AqeelJar/Android-Arduino_Face_Detection_Robot/Arduino Uno Robot with Android Face Detection/README.md

## Arduino Uno Robot with Android Face Detection and Tracking

This folder contains the [Android Device](https://github.com/AqeelJar/Android-Arduino_Face_Detection_Robot/blob/main/Arduino%20Uno%20Robot%20with%20Android%20Face%20Detection/FaceDetectResponseApp.slx) Simulink model and [Arduino Uno Controller](https://github.com/AqeelJar/Android-Arduino_Face_Detection_Robot/blob/main/Arduino%20Uno%20Robot%20with%20Android%20Face%20Detection/ContolArduinoRobot.slx) Simulink model.

Follow the [How to run Section](https://github.com/AqeelJar/Android-Arduino_Face_Detection_Robot/tree/main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) for both devices for this application.
