AqeelJar/Android-Arduino_Face_Detection_Robot/Arduino Uno Robot Control/Readme.md

## Control Arduino Uno Robot with Android Device/s
This folder contains the [Arduino Uno Robot Control](https://github.com/AqeelJar/Android-Arduino_Face_Detection_Robot/blob/main/Arduino%20Uno%20Robot%20Control/ContolArduinoRobot.slx) Simulink model for the Arduino Robot.

This folder also contains [direct serial communication](https://github.com/AqeelJar/Android-Arduino_Face_Detection_Robot/tree/main/Arduino%20Uno%20Robot%20Control/Direct%20Serial%20Communication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) and [TCP/IP communication](https://github.com/AqeelJar/Android-Arduino_Face_Detection_Robot/tree/main/Arduino%20Uno%20Robot%20Control/TCP-IP%20Communication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) folders.

Follow the [How to run Section](https://github.com/AqeelJar/Android-Arduino_Face_Detection_Robot#arduino-uno-controller-controlarduinorobotslx) for this application.
