AqeelJar/Android-Arduino_Face_Detection_Robot/Face Detection App/ReadMe.md

## Face Detection Application on Android Device
This folder contains the [Face Detection and reference Simulink model](https://github.com/AqeelJar/Android-Arduino_Face_Detection_Robot/blob/main/Face%20Detection%20App/FaceDetectionApp.slx) for the Android Device

Follow the [How to Run Section](https://github.com/AqeelJar/Android-Arduino_Face_Detection_Robot/tree/main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) for this application.
