AqeelJar/Android-Arduino_Face_Detection_Robot/Arduino Uno Robot Control/TCP-IP Communication/readme.md

## Button Control using a TCP/IP Communication between Android Devices
This folder contains the [server](https://github.com/AqeelJar/Android-Arduino_Face_Detection_Robot/blob/main/Arduino%20Uno%20Robot%20Control/TCP-IP%20Communication/ButtonControlApp_Server.slx) and [client](https://github.com/AqeelJar/Android-Arduino_Face_Detection_Robot/blob/main/Arduino%20Uno%20Robot%20Control/TCP-IP%20Communication/ButtonControlApp_Client.slx) Simulink models for the android devices.

Follow the [How to run Section](https://github.com/AqeelJar/Android-Arduino_Face_Detection_Robot/tree/main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) for this application
