AqeelJar/Android-Arduino_Face_Detection_Robot/Arduino Uno Robot Control/Direct Serial Communication/readme.md

## Button Control using Direct Serial Communication
This folder contains the [direct serial communication](https://github.com/AqeelJar/Android-Arduino_Face_Detection_Robot/blob/main/Arduino%20Uno%20Robot%20Control/Direct%20Serial%20Communication/ButtonControlApp.slx) Simulink model for the Android device.

Follow the [How to Run Section](https://github.com/AqeelJar/Android-Arduino_Face_Detection_Robot/tree/main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) for this application.
