AqeelJar/Android-Arduino_Face_Detection_Robot/Additional Codes/Obstacle_Avoidance.ino

// Obstacle Avoidance Code
#include <Servo.h>  
Servo myservo;      // create servo object to control servo

int Echo = A4;
int Trig = A5;

#define ENB 5
#define IN1 7
#define IN2 8
#define IN3 9
#define IN4 11
#define ENA 6
#define carSpeed 150
int rightDistance = 0, leftDistance = 0, middleDistance = 0;

void forward(){
  analogWrite(ENA, carSpeed);
  analogWrite(ENB, carSpeed);
  digitalWrite(IN1, HIGH);
  digitalWrite(IN2, LOW);
  digitalWrite(IN3, LOW);
  digitalWrite(IN4, HIGH);
  //Serial.println("Forward");
}

void back() {
  analogWrite(ENA, carSpeed);
  analogWrite(ENB, carSpeed);
  digitalWrite(IN1, LOW);
  digitalWrite(IN2, HIGH);
  digitalWrite(IN3, HIGH);
  digitalWrite(IN4, LOW);
  //Serial.println("Back");
}

void left() {
  analogWrite(ENA, carSpeed);
  analogWrite(ENB, carSpeed);
  digitalWrite(IN1, LOW);
  digitalWrite(IN2, HIGH);
  digitalWrite(IN3, LOW);
  digitalWrite(IN4, HIGH);
  //Serial.println("Left");
}

void right() {
  analogWrite(ENA, carSpeed);
  analogWrite(ENB, carSpeed);
  digitalWrite(IN1, HIGH);
  digitalWrite(IN2, LOW);
  digitalWrite(IN3, HIGH);
  digitalWrite(IN4, LOW);
  //Serial.println("Right");
}

void stop() {
  digitalWrite(ENA, LOW);
  digitalWrite(ENB, LOW);
  //Serial.println("Stop!");
}

//Ultrasonic distance measurement
int getDistance() {
    digitalWrite(Trig, LOW);
    delayMicroseconds(2);
    digitalWrite(Trig, HIGH);
    delayMicroseconds(10);
    digitalWrite(Trig, LOW);
    return (int)pulseIn(Echo, HIGH) / 58;
}

void setup() {
  myservo.attach(3);  
  Serial.begin(9600);
  pinMode(Echo, INPUT);
  pinMode(Trig, OUTPUT);
  pinMode(IN1, OUTPUT);
  pinMode(IN2, OUTPUT);
  pinMode(IN3, OUTPUT);
  pinMode(IN4, OUTPUT);
  pinMode(ENA, OUTPUT);
  pinMode(ENB, OUTPUT);
  stop();
}

void loop() {
    myservo.write(90);  //setservo position according to scaled value
    delay(500);
    middleDistance = getDistance();

    if(middleDistance <= 20) {
      stop();
      delay(500);
      myservo.write(10);
      delay(1000);
      rightDistance = getDistance();

      delay(500);
      myservo.write(90);
      delay(1000);
      myservo.write(180);
      delay(1000);
      leftDistance = getDistance();

      delay(500);
      myservo.write(90);
      delay(1000);
      if(rightDistance > leftDistance) {
        right();
        delay(360);
      }
      else if(rightDistance < leftDistance) {
        left();
        delay(360);
      }
      else if((rightDistance <= 20) || (leftDistance <= 20)) {
        back();
        delay(180);
      }
      else {
        forward();
      }
    }
    else {
        forward();
    }
}
